lucaasporto/biomon_ubiquos/src/mongoose_fs.c

#include "mongoose.h"

static const unsigned char v1[] = {
  31, 139,   8,   0,   0,   0,   0,   0,   0,   3, 172, 125, // ...........}
 123, 119, 218, 198, 246, 232, 223, 247, 126,  10, 208, 201, // {w......~...
 165,  82,  25,  48, 224,  71,  28, 225,   9,  43,  77, 210, // .R.0.G...+M.
  58, 109, 156, 180, 113, 146, 182, 241, 241, 241,  18,  48, // :m..q......0
 128,  98,  33,  81,  73, 248,  81, 195, 253, 236, 119,  63, // .b!QI.Q...w?
 102,  70,  18, 224, 158, 246, 183, 110,  87,  42,  70, 243, // fF.....nW*F.
 220, 179,  95, 179, 247, 158,  25, 249, 164, 254, 234, 253, // .._.........
 203, 143, 191, 255, 252, 186,  54, 203, 231, 209, 243, 147, // ......6.....
 185, 202, 131, 218, 104,  22, 164, 153, 202, 229,  50, 159, // ....h.....2.
 180, 142, 117,  94,  28, 204, 149, 188,   9, 213, 237,  34, // ..u^......."
  73, 243, 218,  40, 137, 115,  21, 231, 210, 185,  13, 199, // I..(.s......
 249,  76, 142, 213,  77,  56,  82,  45, 122,  17, 181,  48, // .L..M8R-z..0
  14, 243,  48, 136,  90, 217,  40, 136, 148, 236, 182,  59, // ..0.Z.(....;
 206, 243, 147,  40, 140, 175, 107, 169, 138, 100,   8,  77, // ...(..k..d.M
 107, 179,  84,  77, 100, 148,  76, 147, 118, 118,  51, 173, // k.TMd.L.vv3.
 229, 247,  11,  37, 195, 121,  48,  85, 123, 240, 218, 188, // ...%.y0U{...
  67,  56, 178, 252,  62,  82, 207, 219, 203,  69, 148, 228, // C8..>R...E..
 130, 127, 106, 223, 154, 132,  63,  84, 147,  36,  85, 246, // ..j...?T.$U.
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
  89,  25, 215, 174, 252,   2, 218, 132,  61, 139, 172, 111, // Y.......=..o
  39,  18,  26, 211, 113,  17,  92, 243,  53, 154, 250,  88, // '...q...5..X
 126, 248,  34, 237, 163,  81, 122,  80,  52,   4, 120, 208, // ~."..QzP4.x.
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
